appliot/Sensor-Stack-Developer-Edition/bom/BOM-Schematic-Sensor-Stack-Developer-Edition_v0.4.csv

ID | Name | Designator | Footprint | Quantity | Manufacturer Part | Manufacturer | Supplier | Supplier Part
1 | LDR | LDR | LDR_3.4_X_1 | 1
2 | Thermistor | TEMP | THERMISTER_MF52_CUS | 1 | MF52A1502F3470 | Shiheng | LCSC | C72411
3 | Roll_Ball_Tilt_Switch | TILTSW | ROLL_BALL_TILT_SW_520D | 1
4 | BL-PBZ1209C2003YB-H | BUZZER1 | BUZZER-R6.0-2P-8PITCH | 1 | BL-PBZ1209C2003YB-H | Dongguan Bolin Elec | LCSC | C187885
5 | WS2812B-B | RGB | LED-5050_4P | 1 | WS2812B-B | Worldsemi | LCSC | C114586
6 | LED-5MM | LED1 | LED-5MM/2.54 | 1 | 5AR2ST10 | EVERLIGHT | LCSC | C52721
7 | 10KΩ | R7,R6,R8 | 0805' | 3 | TC0525D1002T5E | UniOhm | LCSC | C44791
8 | 1KΩ | R9 | 0805' | 1 | TC0525D1002T5E | UniOhm | LCSC | C44791
9 | 10nF(104) | C5 | 0805' | 1 | CL21F104ZBANNNC | SAMSUNG | LCSC | C84714
10 | male connector 1x3 2.54 | C2,C1 | HDR-3X1/2.54 | 2
11 | female connector 1x4 2.54 | C3_I2C | HDR-4X1/2.54 | 1
