appliot/Sensor-Stack-Developer-Edition/sch/Schematic-Sensor-Stack-Developer-Edition_v0.4.pdf

3V3

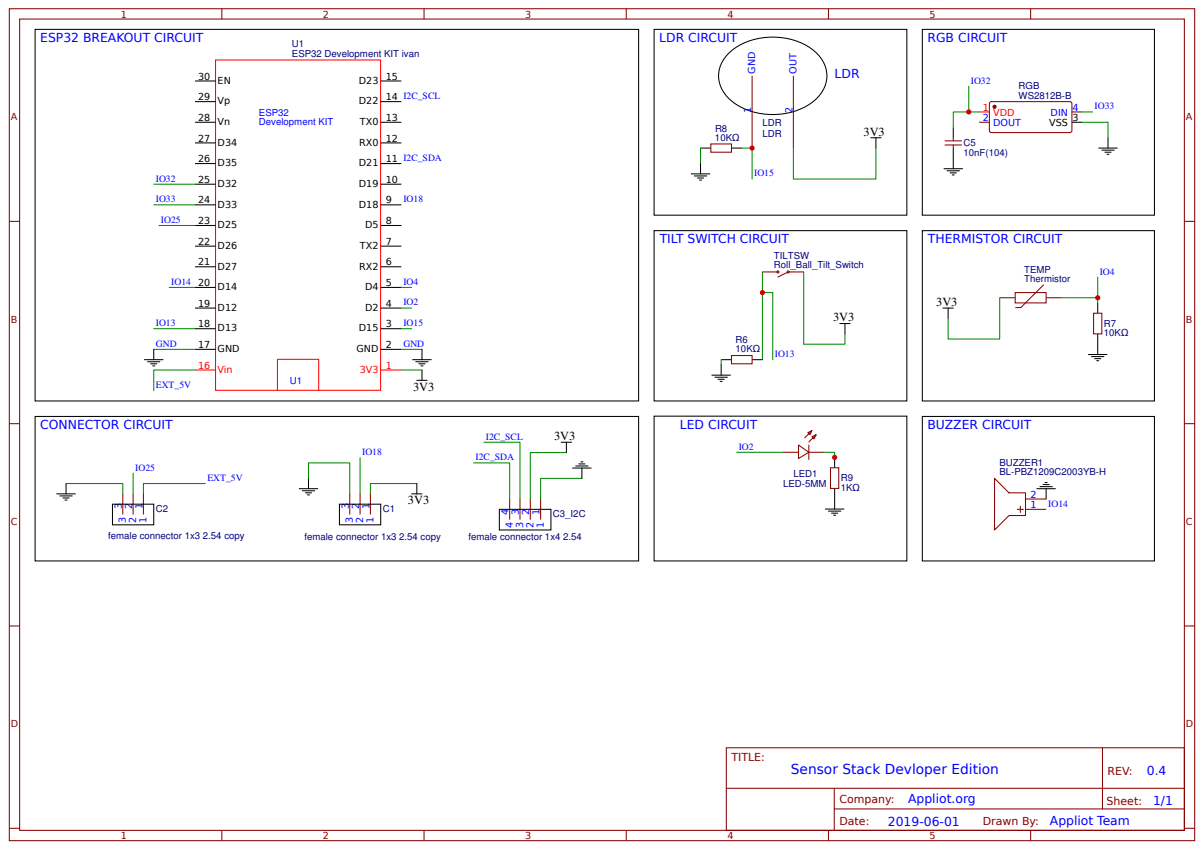
[picture p5: page 1]

Drawn By: Appliot Team
