appliot/Sensor-Stack-Developer-Edition/src/TILT_Demo/TILT_Demo.ino

#include <Wire.h>
#include <Adafruit_SSD1306.h>
#include <Adafruit_GFX.h>
#define SCREEN_WIDTH 128 // OLED display width, in pixels
#define SCREEN_HEIGHT 32 // OLED display height, in pixels
#define OLED_RESET     4 // Reset pin # (or -1 if sharing Arduino reset pin)
Adafruit_SSD1306 display(SCREEN_WIDTH, SCREEN_HEIGHT, &Wire, OLED_RESET);
// 'arrow - Copy', 37x37px

#define OLED_ADDR   0x3C
//Adafruit_SSD1306 display(-1);
#if (SSD1306_LCDHEIGHT != 32)
#error("Height incorrect, please fix Adafruit_SSD1306.h!");
#endif
//Adafruit_SSD1306 display(-1);
//
// 'tilt_icon', 36x26px
const unsigned char tilt_icon1 [] PROGMEM = {
  0x00, 0x00, 0x00, 0x00, 0x00, 0x00, 0x00, 0x00, 0x00, 0x00, 0x00, 0x00, 0x00, 0x00, 0x00, 0x00,
  0x00, 0x00, 0x00, 0x00, 0x00, 0x00, 0x07, 0x80, 0x00, 0x00, 0x07, 0xff, 0xc0, 0x00, 0x00, 0xff,
  0xe0, 0xc0, 0x00, 0x01, 0xe0, 0x00, 0xc0, 0x00, 0x00, 0xc0, 0x00, 0xc0, 0x00, 0x00, 0xc0, 0x00,
  0xe0, 0x00, 0x00, 0xc0, 0x00, 0xe0, 0x00, 0x00, 0x00, 0x00, 0x00, 0x00, 0x07, 0xff, 0xff, 0xfe,
  0x00, 0x07, 0xff, 0xff, 0xfe, 0x00, 0x00, 0x00, 0x00, 0x00, 0x00, 0x00, 0x70, 0x00, 0x30, 0x00,
  0x00, 0x70, 0x00, 0x30, 0x00, 0x00, 0x30, 0x00, 0x30, 0x00, 0x00, 0x30, 0x00, 0x78, 0x00, 0x00,
  0x30, 0x7f, 0xf0, 0x00, 0x00, 0x3f, 0xfe, 0x00, 0x00, 0x00, 0x1e, 0x00, 0x00, 0x00, 0x00, 0x00,
  0x00, 0x00, 0x00, 0x00, 0x00, 0x00, 0x00, 0x00, 0x00, 0x00, 0x00, 0x00, 0x00, 0x00, 0x00, 0x00,
  0x00, 0x00
};

// 'tilt_icon2', 27x19px
const unsigned char tilt_icon2 [] PROGMEM = {
  0x00, 0x00, 0x00, 0x00, 0x60, 0x00, 0x00, 0x00, 0x38, 0x03, 0xc0, 0x00, 0x1c, 0x1f, 0xe0, 0x00,
  0x0f, 0xfb, 0xb8, 0x00, 0x03, 0xc3, 0x1c, 0x00, 0x01, 0xe7, 0x0f, 0x00, 0x06, 0x76, 0x03, 0x00,
  0x0e, 0x3c, 0x07, 0x00, 0x1c, 0x4e, 0x06, 0x00, 0x1f, 0xe7, 0x0e, 0x00, 0x3f, 0x01, 0xcc, 0x00,
  0x38, 0x00, 0xfc, 0x00, 0x0e, 0x00, 0x78, 0x00, 0x07, 0x01, 0x9c, 0x00, 0x01, 0xdf, 0xcf, 0x00,
  0x1f, 0xff, 0xf3, 0x80, 0x1f, 0xff, 0xf9, 0xc0, 0x00, 0x00, 0x00, 0x40
};

// 'tilt_icon2_mirror - Copy', 27x19px
const unsigned char tilt_icon2_mirror [] PROGMEM = {
  0x00, 0x00, 0x00, 0x00, 0x00, 0x00, 0x00, 0xc0, 0x00, 0x78, 0x03, 0x80, 0x00, 0xff, 0x07, 0x00,
  0x03, 0xbb, 0xfe, 0x00, 0x07, 0x18, 0x78, 0x00, 0x1e, 0x1c, 0xf0, 0x00, 0x18, 0x0d, 0xcc, 0x00,
  0x1c, 0x07, 0x8e, 0x00, 0x0c, 0x0e, 0x47, 0x00, 0x0e, 0x1c, 0xff, 0x00, 0x06, 0x70, 0x1f, 0x80,
  0x07, 0xe0, 0x03, 0x80, 0x03, 0xc0, 0x0e, 0x00, 0x07, 0x30, 0x1c, 0x00, 0x1e, 0x7f, 0x70, 0x00,
  0x39, 0xff, 0xff, 0x00, 0x73, 0xff, 0xff, 0x00, 0x40, 0x00, 0x00, 0x00
};

//#if (SSD1306_LCDHEIGHT != 64)
////#error("Height incorrect, please fix Adafruit_SSD1306.h!");
//#endif
int Tilt_Pin = 13;
int Tilt_data;
String Tilt_String;
char linebuf[80];
int charcount = 0;

void setup() {
  Serial.begin(115200);

  pinMode(Tilt_Pin, INPUT);

  display.begin(SSD1306_SWITCHCAPVCC, OLED_ADDR);
  display.clearDisplay();

}

void loop() {
  Tilt_data = digitalRead(Tilt_Pin);
  display.setTextSize(1);
  display.setTextColor(WHITE);
  if (Tilt_data == 1)
  {
    Tilt_String = "ON";
    display.drawBitmap(85, 10,  tilt_icon2 , 27, 19, WHITE);
    display.display();

  }
  else
  {
    Tilt_String = "OFF";
    display.drawBitmap(85, 10,  tilt_icon2_mirror , 27, 19, WHITE);
    display.display();
  }

  Serial.print("Tilt Switch: ");
  Serial.print(Tilt_data);

  display.setTextSize(2);
  display.setTextColor(WHITE);
  display.setCursor(42, 0);
  display.print("TILT  ");
  display.setCursor(40, 15);
  display.print(Tilt_String);
  display.display();
  display.setTextSize(1);
  display.setTextColor(WHITE);
  // drawBitmap(x position, y position, bitmap data, bitmap width, bitmap height, color)
  //display.drawBitmap(80, 8,  tilt_icon1 , 36, 26, WHITE);
  //  display.drawBitmap(85, 10,  tilt_icon2_mirror , 27, 19, WHITE);
  //display.display();

  delay(1000);
  display.clearDisplay();

  // put your main code here, to run repeatedly:

}
